codeTom/miniproject/cell_illuminator.png

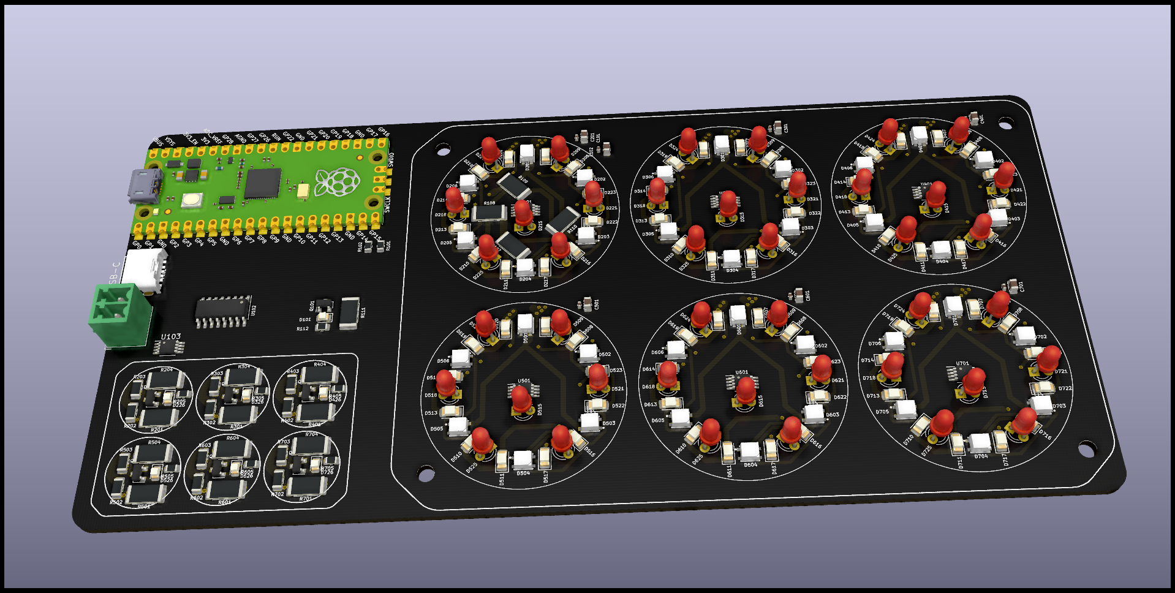
cell_illuminator.png
