codeTom/miniproject/README.md

## Cell photobiomodulation platform

Hardware contains the design files for the PCB (kicad) and for 3D printed components (OpenSCAD).
