codeTom/miniproject/hardware/cover.stl

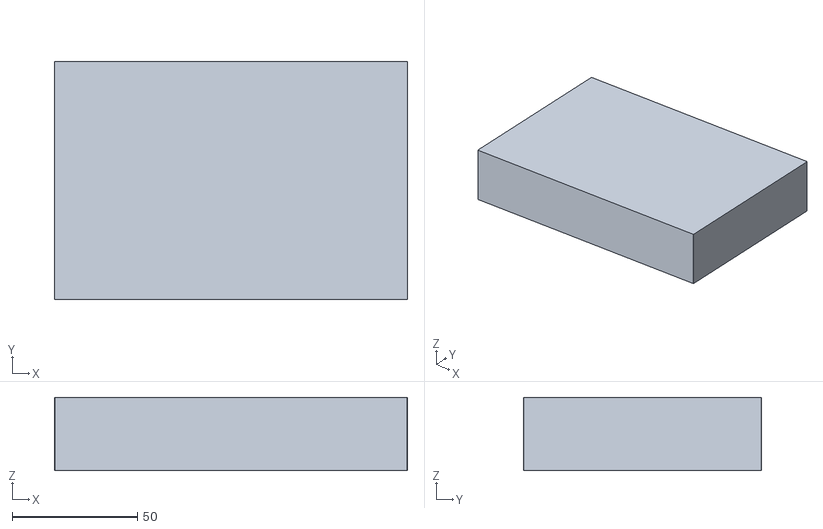
[picture p2: CAD file, 2022-04-08]
hardware/cover.stl
140.8 x 95.0 x 29.2
