codeTom/miniproject/hardware/drawing.dxf

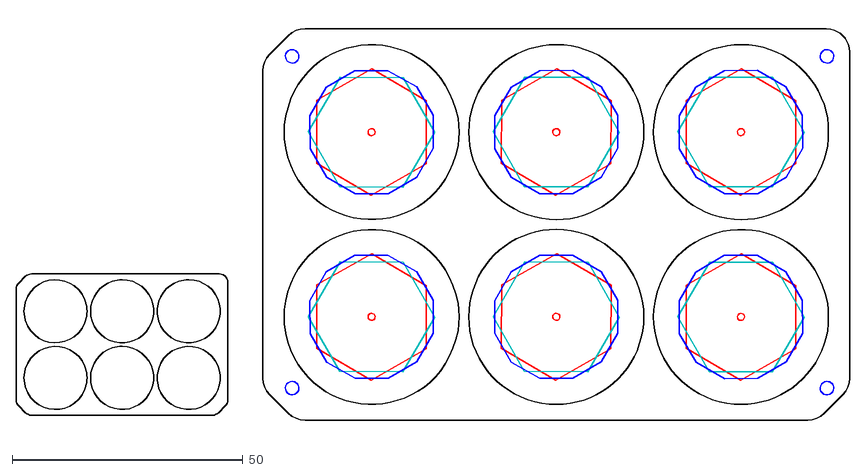
[picture p3: CAD file, 2022-04-08]
hardware/drawing.dxf
180.8 x 90.3
