codeTom/miniproject/hardware/sma_holder_v2.stl

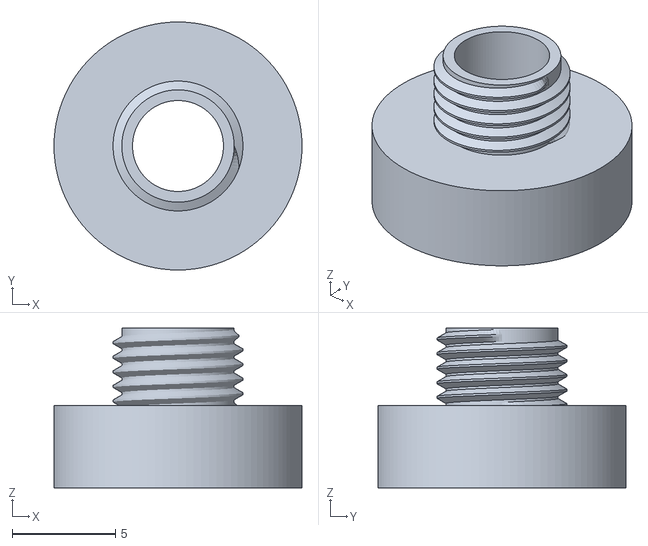
[picture p4: CAD file, 2022-04-08]
hardware/sma_holder_v2.stl
12.0 x 12.0 x 7.74
