codeTom/miniproject/hardware/well_holder_v3.stl

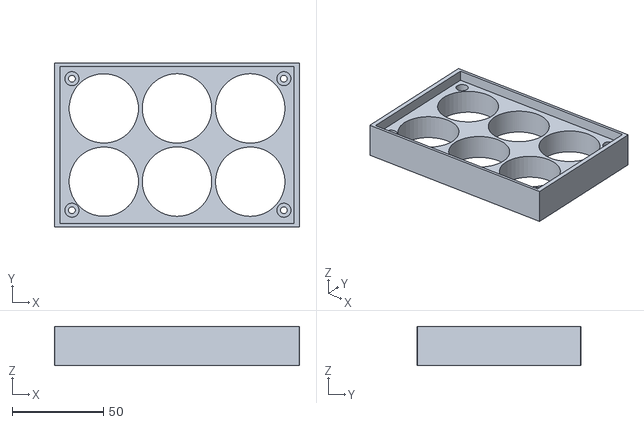
[picture p5: CAD file, 2022-04-08]
hardware/well_holder_v3.stl
134.1 x 89.6 x 21.5
