codeTom/miniproject/hardware/cover_v2.stl

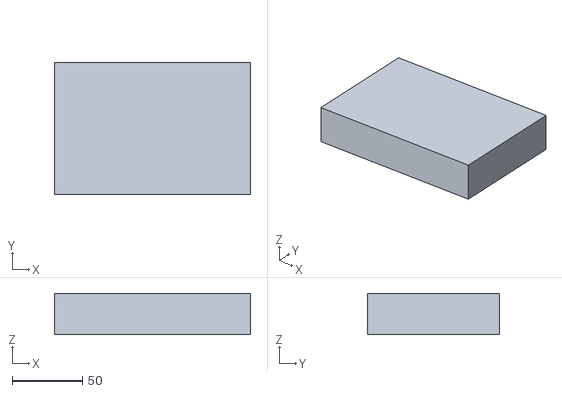
[picture p6: CAD file, 2022-04-08]
hardware/cover_v2.stl
139.4 x 94.1 x 29.2
