codeTom/miniproject/hardware/outline.dxf

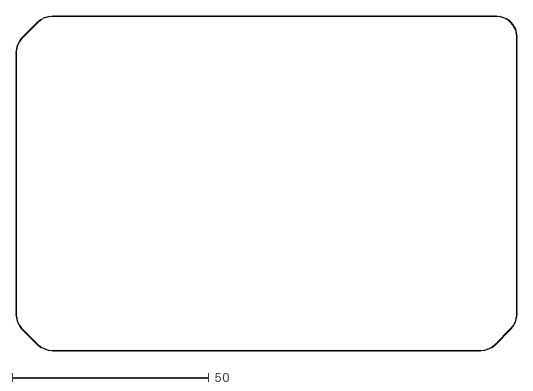
[picture p7: CAD file, 2022-04-08]
hardware/outline.dxf
127.3 x 84.9
