codeTom/miniproject/hardware/wells.dxf

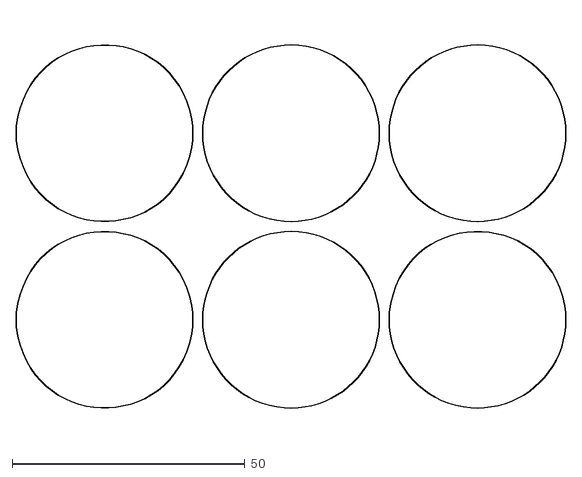
[picture p8: CAD file, 2022-04-08]
hardware/wells.dxf
118.1 x 90.3
