codeTom/miniproject/hardware/drawing_silk.dxf

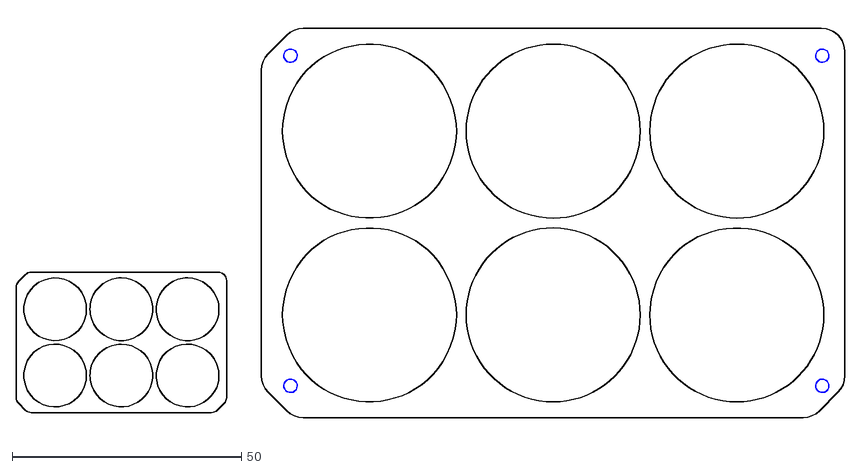
[picture p9: CAD file, 2022-04-08]
hardware/drawing_silk.dxf
180.8 x 90.3
