codeTom/miniproject/hardware/screws.dxf

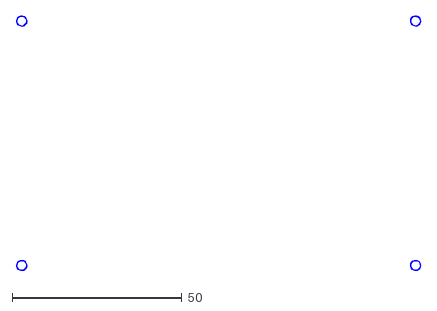
[picture p10: CAD file, 2022-04-08]
hardware/screws.dxf
119.0 x 75.0
