codeTom/miniproject/hardware/cell_illuminator.kicad_pcb

## KiCad design hardware/cell_illuminator.kicad_pcb (2022-04-08)

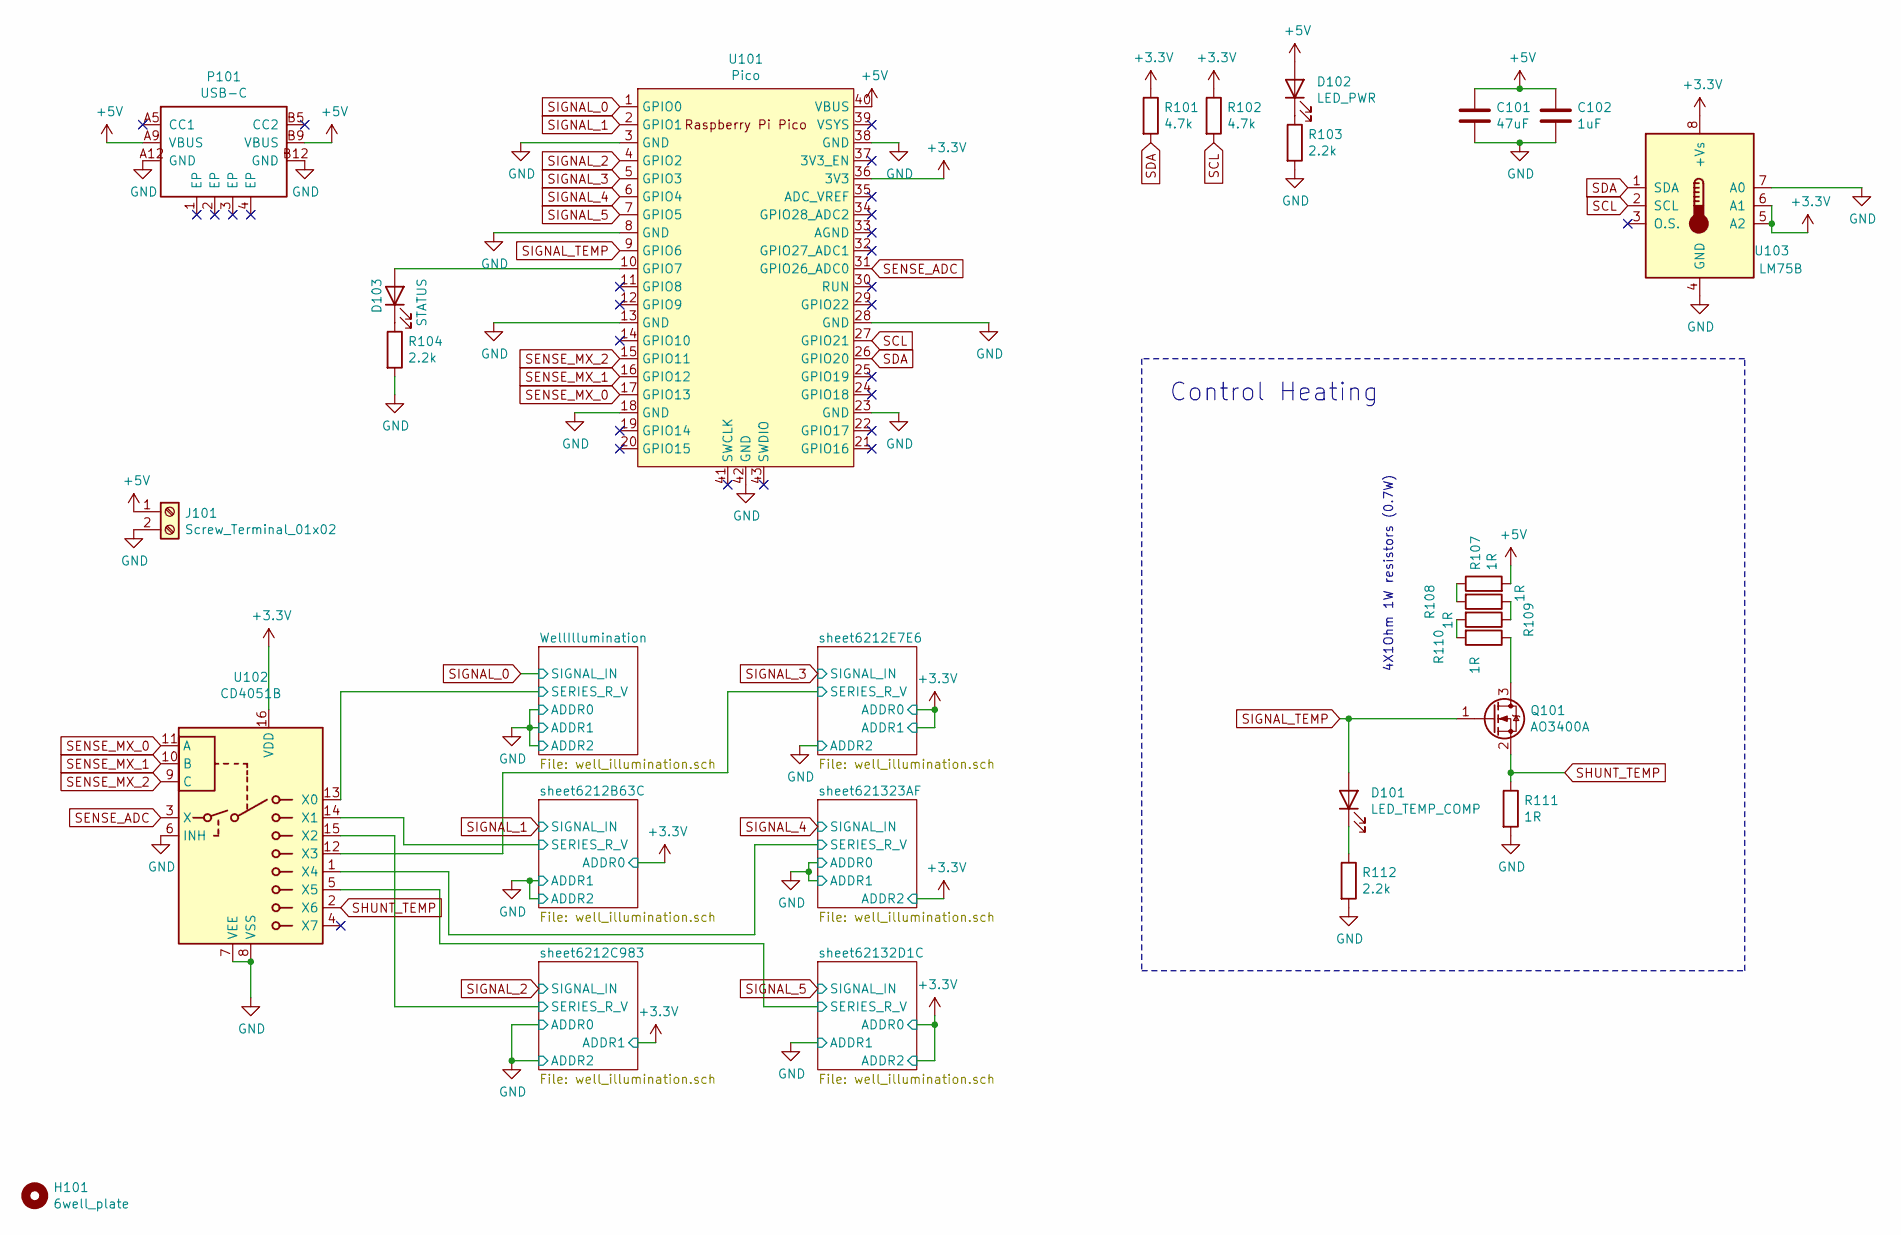
[picture p11: schematic cell_illuminator.sch]

Parts:
C101: 47uF; C_0805_2012Metric; JLCPCB C16780
C102: 1uF; C_0402_1005Metric; JLCPCB C52923
D101: LED_TEMP_COMP; LED_0805_2012Metric; JLCPCB C2293
D102: LED_PWR; LED_0805_2012Metric; JLCPCB C2293
D103: STATUS; LED_0805_2012Metric; JLCPCB C2293
H101: 6well_plate
J101: Screw_Terminal_01x02; PhoenixContact_MCV_1,5_2-G-3.5_1x02_P3.50mm_Vertical
P101: USB-C; TYPE-C-SMD_TYPE-C-31-M-16; JLCPCB C709355
Q101: AO3400A; SOT-23; JLCPCB C20917
R101, R102: 4.7k; R_0805_2012Metric; JLCPCB C17673
R103, R104, R112: 2.2k; R_0805_2012Metric; JLCPCB C17520
R107, R108, R109, R110, R111: 1R; R_2512_6332Metric; JLCPCB C11254
U101: Pico; RPi_Pico_SMD_TH
U102: CD4051B; SOIC-16_3.9x9.9mm_P1.27mm; JLCPCB C21379
U103: LM75B; MSOP-8_3x3mm_P0.65mm; JLCPCB C2837470

Connections:
+3V3: R101.1, R102.1, U101.36 (3V3), U102.16 (VDD), U103.5 (A2), U103.6 (A1), U103.8 (+Vs); also elsewhere on the board
+5V: C101.1, C102.1, D102.2 (A), J101.1, P101.A9 (VBUS), P101.B9 (VBUS), R107.2, U101.40 (VBUS); also elsewhere on the board
/WellIllumination/SERIES_R_V: U102.13 (X0); also elsewhere on the board
/sheet6212B63C/SERIES_R_V: U102.14 (X1); also elsewhere on the board
/sheet6212C983/SERIES_R_V: U102.15 (X2); also elsewhere on the board
/sheet6212E7E6/SERIES_R_V: U102.12 (X3); also elsewhere on the board
/sheet62132D1C/SERIES_R_V: U102.5 (X5); also elsewhere on the board
/sheet621323AF/SERIES_R_V: U102.1 (X4); also elsewhere on the board
GND: C101.2, C102.2, J101.2, P101.A12 (GND), P101.B12 (GND), R103.2, R104.2, R111.2, R112.2, U101.3 (GND), U101.8 (GND), U101.13 (GND), U101.18 (GND), U101.23 (GND), U101.28 (GND), U101.38 (GND), U101.42 (GND), U102.6 (INH), U102.7 (VEE), U102.8 (VSS), U103.4 (GND), U103.7 (A0); also elsewhere on the board
unnamed: D101.1 (K), R112.1
unnamed: D102.1 (K), R103.1
unnamed: D103.1 (K), R104.1
unnamed: D103.2 (A), U101.10 (GPIO7)
unnamed: Q101.3 (D), R110.1
unnamed: R107.1, R108.2
unnamed: R108.1, R109.1
unnamed: R109.2, R110.2
SCL: R102.2, U101.27 (GPIO21), U103.2 (SCL); also elsewhere on the board
SDA: R101.2, U101.26 (GPIO20), U103.1 (SDA); also elsewhere on the board
SENSE_ADC: U101.31 (GPIO26_ADC0), U102.3 (X)
SENSE_MX_0: U101.17 (GPIO13), U102.11 (A)
SENSE_MX_1: U101.16 (GPIO12), U102.10 (B)
SENSE_MX_2: U101.15 (GPIO11), U102.9 (C)
SHUNT_TEMP: Q101.2 (S), R111.1, U102.2 (X6)
SIGNAL_0: U101.1 (GPIO0); also elsewhere on the board
SIGNAL_1: U101.2 (GPIO1); also elsewhere on the board
SIGNAL_2: U101.4 (GPIO2); also elsewhere on the board
SIGNAL_3: U101.5 (GPIO3); also elsewhere on the board
SIGNAL_4: U101.6 (GPIO4); also elsewhere on the board
SIGNAL_5: U101.7 (GPIO5); also elsewhere on the board
SIGNAL_TEMP: D101.2 (A), Q101.1 (G), U101.9 (GPIO6)

Notes on the sheet:
4X1Ohm 1W resistors (0.7W)
Control Heating

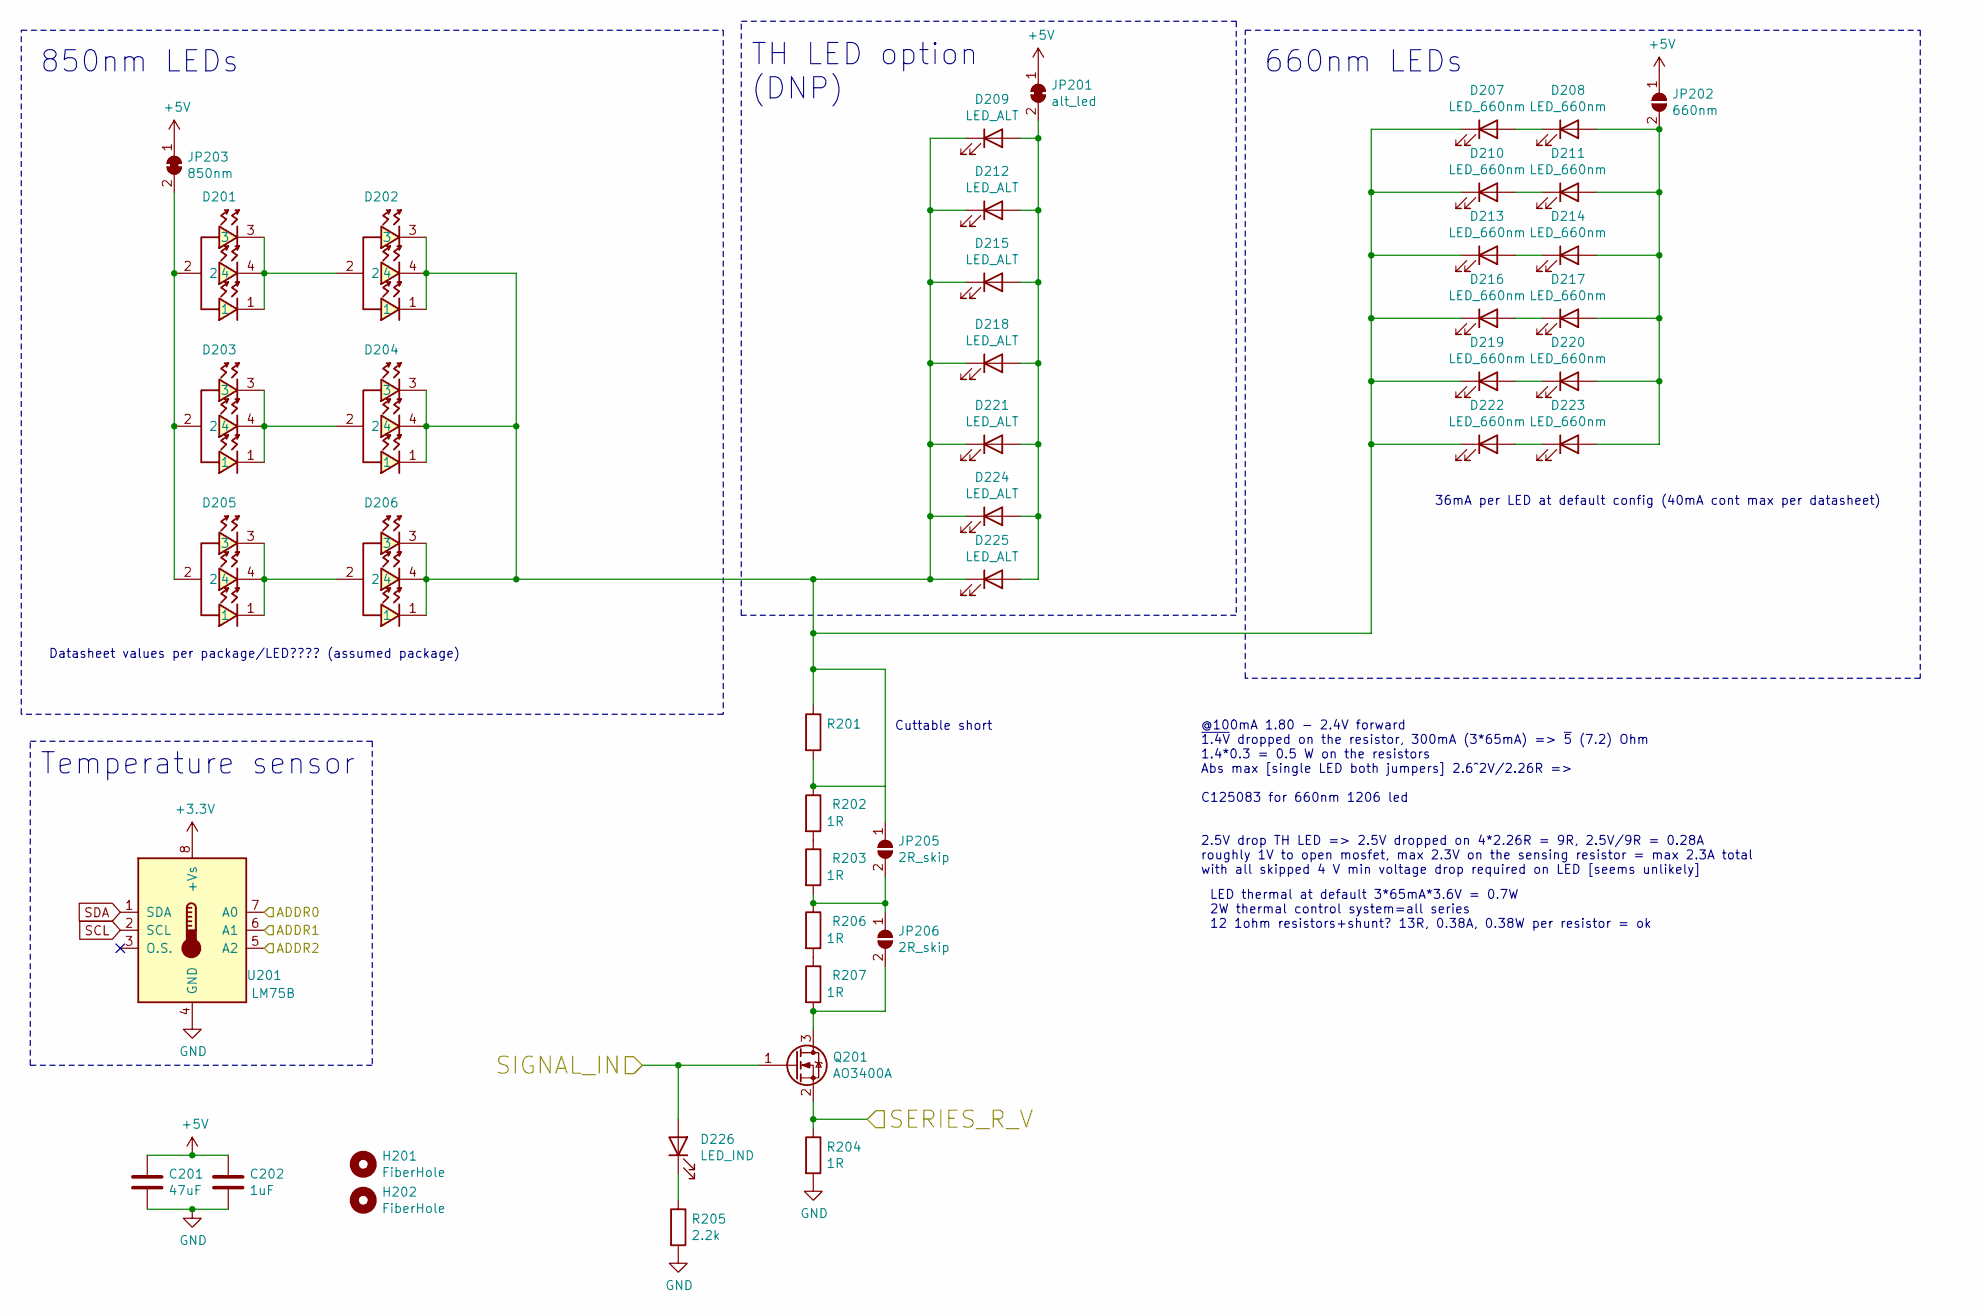
[picture p12: schematic well_illumination.sch]

Parts:
C201: 47uF; C_0805_2012Metric; JLCPCB C16780
C202: 1uF; C_0402_1005Metric; JLCPCB C52923
D201, D202, D203, D204, D205, D206: IR; LED-SMD_4P-L3.2-W2.8-P1.70-TL; JLCPCB C264604
D207, D208, D210, D211, D213, D214, D216, D217, D219, D220, D222, D223: LED_660nm; LED_1206_3216Metric; JLCPCB C125083
D209, D212, D215, D218, D221, D224, D225: LED_ALT; LED_D3.0mm
D226: LED_IND; LED_0805_2012Metric; JLCPCB C2293
H201, H202: FiberHole; MountingHole_3.2mm_M3_small
JP201: alt_led; SolderJumper-2_P1.3mm_Bridged_RoundedPad1.0x1.5mm
JP202: 660nm; SolderJumper-2_P1.3mm_Open_TrianglePad1.0x1.5mm
JP203: 850nm; SolderJumper-2_P1.3mm_Bridged_RoundedPad1.0x1.5mm
JP205, JP206: 2R_skip; SolderJumper-2_P1.3mm_Open_TrianglePad1.0x1.5mm
Q201: AO3400A; SOT-23; JLCPCB C20917
R201: THT; R_Axial_DIN0204_L3.6mm_D1.6mm_P1.90mm_Vertical
R202, R203, R204, R206, R207: 1R; R_2512_6332Metric; JLCPCB C11254
R205: 2.2k; R_0805_2012Metric; JLCPCB C17520
U201: LM75B; MSOP-8_3x3mm_P0.65mm; JLCPCB C2837470

Connections:
+3V3: U201.8 (+Vs); also elsewhere on the board
+5V: C201.1, C202.1, JP201.1 (A), JP202.1 (A), JP203.1 (A); also elsewhere on the board
/WellIllumination/SERIES_R_V: Q201.2 (S), R204.1; also elsewhere on the board
GND: C201.2, C202.2, R204.2, R205.2, U201.4 (GND), U201.5 (A2), U201.6 (A1), U201.7 (A0); also elsewhere on the board
unnamed: D201.1, D201.3, D201.4, D202.2
unnamed: D201.2, D203.2, D205.2, JP203.2 (B)
unnamed: D202.1, D202.3, D202.4, D204.1, D204.3, D204.4, D206.1, D206.3, D206.4, D207.1 (K), D209.1 (K), D210.1 (K), D212.1 (K), D213.1 (K), D215.1 (K), D216.1 (K), D218.1 (K), D219.1 (K), D221.1 (K), D222.1 (K), D224.1 (K), D225.1 (K), JP205.1 (A), R201.1, R201.2, R202.1
unnamed: D203.1, D203.3, D203.4, D204.2
unnamed: D205.1, D205.3, D205.4, D206.2
unnamed: D207.2 (A), D208.1 (K)
unnamed: D208.2 (A), D211.2 (A), D214.2 (A), D217.2 (A), D220.2 (A), D223.2 (A), JP202.2 (B)
unnamed: D209.2 (A), D212.2 (A), D215.2 (A), D218.2 (A), D221.2 (A), D224.2 (A), D225.2 (A), JP201.2 (B)
unnamed: D210.2 (A), D211.1 (K)
unnamed: D213.2 (A), D214.1 (K)
unnamed: D216.2 (A), D217.1 (K)
unnamed: D219.2 (A), D220.1 (K)
unnamed: D222.2 (A), D223.1 (K)
unnamed: D226.1 (K), R205.1
unnamed: JP205.2 (B), JP206.1 (A), R203.2, R206.1
unnamed: JP206.2 (B), Q201.3 (D), R207.2
unnamed: R202.2, R203.1
unnamed: R206.2, R207.1
SCL: U201.2 (SCL); also elsewhere on the board
SDA: U201.1 (SDA); also elsewhere on the board
SIGNAL_0: D226.2 (A), Q201.1 (G); also elsewhere on the board

Parts of its further copies:
C301, C401, C501, C601, C701: 47uF; C_0805_2012Metric; JLCPCB C16780
C302, C402, C502, C602, C702: 1uF; C_0402_1005Metric; JLCPCB C52923
D301, D302, D303, D304, D305, D306, D401, D402, D403, D404, D405, D406, D501, D502, D503, D504, D505, D506, D601, D602, D603, D604, D605, D606, D701, D702, D703, D704, D705, D706: IR; LED-SMD_4P-L3.2-W2.8-P1.70-TL; JLCPCB C264604
D307, D308, D310, D311, D313, D314, D316, D317, D319, D320, D322, D323, D407, D408, D410, D411, D413, D414, D416, D417, D419, D420, D422, D423, D507, D508, D510, D511, D513, D514, D516, D517, D519, D520, D522, D523, D607, D608, D610, D611, D613, D614, D616, D617, D619, D620, D622, D623, D707, D708, D710, D711, D713, D714, D716, D717, D719, D720, D722, D723: LED_660nm; LED_1206_3216Metric; JLCPCB C125083
D309, D312, D315, D318, D321, D324, D325, D409, D412, D415, D418, D421, D424, D425, D509, D512, D515, D518, D521, D524, D525, D609, D612, D615, D618, D621, D624, D625, D709, D712, D715, D718, D721, D724, D725: LED_ALT; LED_D3.0mm
D326, D426, D526, D626, D726: LED_IND; LED_0805_2012Metric; JLCPCB C2293
H301, H302, H401, H402, H501, H502, H601, H602, H701, H702: FiberHole; MountingHole_3.2mm_M3_small
JP301, JP401, JP501, JP601, JP701: alt_led; SolderJumper-2_P1.3mm_Bridged_RoundedPad1.0x1.5mm
JP302, JP402, JP502, JP602, JP702: 660nm; SolderJumper-2_P1.3mm_Open_TrianglePad1.0x1.5mm
JP303, JP403, JP503, JP603, JP703: 850nm; SolderJumper-2_P1.3mm_Bridged_RoundedPad1.0x1.5mm
JP305, JP306, JP405, JP406, JP505, JP506, JP605, JP606, JP705, JP706: 2R_skip; SolderJumper-2_P1.3mm_Open_TrianglePad1.0x1.5mm
Q301, Q401, Q501, Q601, Q701: AO3400A; SOT-23; JLCPCB C20917
R302, R303, R304, R306, R307, R402, R403, R404, R406, R407, R502, R503, R504, R506, R507, R602, R603, R604, R606, R607, R702, R703, R704, R706, R707: 1R; R_2512_6332Metric; JLCPCB C11254
R305, R405, R505, R605, R705: 2.2k; R_0805_2012Metric; JLCPCB C17520
U301, U401, U501, U601, U701: LM75B; MSOP-8_3x3mm_P0.65mm; JLCPCB C2837470

Connections of its further copies:
+3V3: U301.7 (A0), U301.8 (+Vs), U401.6 (A1), U401.8 (+Vs), U501.5 (A2), U501.7 (A0), U501.8 (+Vs), U601.5 (A2), U601.8 (+Vs), U701.6 (A1), U701.7 (A0), U701.8 (+Vs); also elsewhere on the board
+5V: C301.1, C302.1, C401.1, C402.1, C501.1, C502.1, C601.1, C602.1, C701.1, C702.1, JP301.1 (A), JP302.1 (A), JP303.1 (A), JP401.1 (A), JP402.1 (A), JP403.1 (A), JP501.1 (A), JP502.1 (A), JP503.1 (A), JP601.1 (A), JP602.1 (A), JP603.1 (A), JP701.1 (A), JP702.1 (A), JP703.1 (A); also elsewhere on the board
/sheet6212B63C/SERIES_R_V: Q301.2 (S), R304.1; also elsewhere on the board
/sheet6212C983/SERIES_R_V: Q401.2 (S), R404.1; also elsewhere on the board
/sheet6212E7E6/SERIES_R_V: Q701.2 (S), R704.1; also elsewhere on the board
/sheet62132D1C/SERIES_R_V: Q501.2 (S), R504.1; also elsewhere on the board
/sheet621323AF/SERIES_R_V: Q601.2 (S), R604.1; also elsewhere on the board
GND: C301.2, C302.2, C401.2, C402.2, C501.2, C502.2, C601.2, C602.2, C701.2, C702.2, R304.2, R305.2, R404.2, R405.2, R504.2, R505.2, R604.2, R605.2, R704.2, R705.2, U301.4 (GND), U301.5 (A2), U301.6 (A1), U401.4 (GND), U401.5 (A2), U401.7 (A0), U501.4 (GND), U501.6 (A1), U601.4 (GND), U601.6 (A1), U601.7 (A0), U701.4 (GND), U701.5 (A2); also elsewhere on the board
unnamed: D301.1, D301.3, D301.4, D302.2
unnamed: D301.2, D303.2, D305.2, JP303.2 (B)
unnamed 29: D302.1, D302.3, D302.4, D304.1, D304.3, D304.4, D306.1, D306.3, D306.4, D307.1 (K), D309.1 (K), D310.1 (K), D312.1 (K), D313.1 (K), D315.1 (K), D316.1 (K), D318.1 (K), D319.1 (K), D321.1 (K), D322.1 (K), D324.1 (K), D325.1 (K), JP305.1 (A), R302.1; also elsewhere on the board
unnamed: D303.1, D303.3, D303.4, D304.2
unnamed: D305.1, D305.3, D305.4, D306.2
unnamed: D307.2 (A), D308.1 (K)
unnamed: D308.2 (A), D311.2 (A), D314.2 (A), D317.2 (A), D320.2 (A), D323.2 (A), JP302.2 (B)
unnamed: D309.2 (A), D312.2 (A), D315.2 (A), D318.2 (A), D321.2 (A), D324.2 (A), D325.2 (A), JP301.2 (B)
unnamed: D310.2 (A), D311.1 (K)
unnamed: D313.2 (A), D314.1 (K)
unnamed: D316.2 (A), D317.1 (K)
unnamed: D319.2 (A), D320.1 (K)
unnamed: D322.2 (A), D323.1 (K)
unnamed: D326.1 (K), R305.1
unnamed: D401.1, D401.3, D401.4, D402.2
unnamed: D401.2, D403.2, D405.2, JP403.2 (B)
unnamed 43: D402.1, D402.3, D402.4, D404.1, D404.3, D404.4, D406.1, D406.3, D406.4, D407.1 (K), D409.1 (K), D410.1 (K), D412.1 (K), D413.1 (K), D415.1 (K), D416.1 (K), D418.1 (K), D419.1 (K), D421.1 (K), D422.1 (K), D424.1 (K), D425.1 (K), JP405.1 (A), R402.1; also elsewhere on the board
unnamed: D403.1, D403.3, D403.4, D404.2
unnamed: D405.1, D405.3, D405.4, D406.2
unnamed: D407.2 (A), D408.1 (K)
unnamed: D408.2 (A), D411.2 (A), D414.2 (A), D417.2 (A), D420.2 (A), D423.2 (A), JP402.2 (B)
unnamed: D409.2 (A), D412.2 (A), D415.2 (A), D418.2 (A), D421.2 (A), D424.2 (A), D425.2 (A), JP401.2 (B)
unnamed: D410.2 (A), D411.1 (K)
unnamed: D413.2 (A), D414.1 (K)
unnamed: D416.2 (A), D417.1 (K)
unnamed: D419.2 (A), D420.1 (K)
unnamed: D422.2 (A), D423.1 (K)
unnamed: D426.1 (K), R405.1
unnamed: D501.1, D501.3, D501.4, D502.2
unnamed: D501.2, D503.2, D505.2, JP503.2 (B)
unnamed 57: D502.1, D502.3, D502.4, D504.1, D504.3, D504.4, D506.1, D506.3, D506.4, D507.1 (K), D509.1 (K), D510.1 (K), D512.1 (K), D513.1 (K), D515.1 (K), D516.1 (K), D518.1 (K), D519.1 (K), D521.1 (K), D522.1 (K), D524.1 (K), D525.1 (K), JP505.1 (A), R502.1; also elsewhere on the board
unnamed: D503.1, D503.3, D503.4, D504.2
unnamed: D505.1, D505.3, D505.4, D506.2
unnamed: D507.2 (A), D508.1 (K)
unnamed: D508.2 (A), D511.2 (A), D514.2 (A), D517.2 (A), D520.2 (A), D523.2 (A), JP502.2 (B)
unnamed: D509.2 (A), D512.2 (A), D515.2 (A), D518.2 (A), D521.2 (A), D524.2 (A), D525.2 (A), JP501.2 (B)
unnamed: D510.2 (A), D511.1 (K)
unnamed: D513.2 (A), D514.1 (K)
unnamed: D516.2 (A), D517.1 (K)
unnamed: D519.2 (A), D520.1 (K)
unnamed: D522.2 (A), D523.1 (K)
unnamed: D526.1 (K), R505.1
unnamed: D601.1, D601.3, D601.4, D602.2
unnamed: D601.2, D603.2, D605.2, JP603.2 (B)
unnamed 71: D602.1, D602.3, D602.4, D604.1, D604.3, D604.4, D606.1, D606.3, D606.4, D607.1 (K), D609.1 (K), D610.1 (K), D612.1 (K), D613.1 (K), D615.1 (K), D616.1 (K), D618.1 (K), D619.1 (K), D621.1 (K), D622.1 (K), D624.1 (K), D625.1 (K), JP605.1 (A), R602.1; also elsewhere on the board
unnamed: D603.1, D603.3, D603.4, D604.2
unnamed: D605.1, D605.3, D605.4, D606.2
unnamed: D607.2 (A), D608.1 (K)
unnamed: D608.2 (A), D611.2 (A), D614.2 (A), D617.2 (A), D620.2 (A), D623.2 (A), JP602.2 (B)
unnamed: D609.2 (A), D612.2 (A), D615.2 (A), D618.2 (A), D621.2 (A), D624.2 (A), D625.2 (A), JP601.2 (B)
unnamed: D610.2 (A), D611.1 (K)
unnamed: D613.2 (A), D614.1 (K)
unnamed: D616.2 (A), D617.1 (K)
unnamed: D619.2 (A), D620.1 (K)
unnamed: D622.2 (A), D623.1 (K)
unnamed: D626.1 (K), R605.1
unnamed: D701.1, D701.3, D701.4, D702.2
unnamed: D701.2, D703.2, D705.2, JP703.2 (B)
unnamed 85: D702.1, D702.3, D702.4, D704.1, D704.3, D704.4, D706.1, D706.3, D706.4, D707.1 (K), D709.1 (K), D710.1 (K), D712.1 (K), D713.1 (K), D715.1 (K), D716.1 (K), D718.1 (K), D719.1 (K), D721.1 (K), D722.1 (K), D724.1 (K), D725.1 (K), JP705.1 (A), R702.1; also elsewhere on the board
unnamed: D703.1, D703.3, D703.4, D704.2
unnamed: D705.1, D705.3, D705.4, D706.2
unnamed: D707.2 (A), D708.1 (K)
unnamed: D708.2 (A), D711.2 (A), D714.2 (A), D717.2 (A), D720.2 (A), D723.2 (A), JP702.2 (B)
unnamed: D709.2 (A), D712.2 (A), D715.2 (A), D718.2 (A), D721.2 (A), D724.2 (A), D725.2 (A), JP701.2 (B)
unnamed: D710.2 (A), D711.1 (K)
unnamed: D713.2 (A), D714.1 (K)
unnamed: D716.2 (A), D717.1 (K)
unnamed: D719.2 (A), D720.1 (K)
unnamed: D722.2 (A), D723.1 (K)
unnamed: D726.1 (K), R705.1
unnamed: JP305.2 (B), JP306.1 (A), R303.2, R306.1
unnamed: JP306.2 (B), Q301.3 (D), R307.2
unnamed: JP405.2 (B), JP406.1 (A), R403.2, R406.1
unnamed: JP406.2 (B), Q401.3 (D), R407.2
unnamed: JP505.2 (B), JP506.1 (A), R503.2, R506.1
unnamed: JP506.2 (B), Q501.3 (D), R507.2
unnamed: JP605.2 (B), JP606.1 (A), R603.2, R606.1
unnamed: JP606.2 (B), Q601.3 (D), R607.2
unnamed: JP705.2 (B), JP706.1 (A), R703.2, R706.1
unnamed: JP706.2 (B), Q701.3 (D), R707.2
unnamed: R302.2, R303.1
unnamed: R306.2, R307.1
unnamed: R402.2, R403.1
unnamed: R406.2, R407.1
unnamed: R502.2, R503.1
unnamed: R506.2, R507.1
unnamed: R602.2, R603.1
unnamed: R606.2, R607.1
unnamed: R702.2, R703.1
unnamed: R706.2, R707.1
SCL: U301.2 (SCL), U401.2 (SCL), U501.2 (SCL), U601.2 (SCL), U701.2 (SCL); also elsewhere on the board
SDA: U301.1 (SDA), U401.1 (SDA), U501.1 (SDA), U601.1 (SDA), U701.1 (SDA); also elsewhere on the board
SIGNAL_1: D326.2 (A), Q301.1 (G); also elsewhere on the board
SIGNAL_2: D426.2 (A), Q401.1 (G); also elsewhere on the board
SIGNAL_3: D726.2 (A), Q701.1 (G); also elsewhere on the board
SIGNAL_4: D626.2 (A), Q601.1 (G); also elsewhere on the board
SIGNAL_5: D526.2 (A), Q501.1 (G); also elsewhere on the board

Notes on the sheet:
@100mA 1.80 - 2.4V forward ~1.4V dropped on the resistor, 300mA (3*65mA) => ~5 (7.2) Ohm 1.4*0.3 = 0.5 W on the resistors Abs max [single LED both jumpers] 2.6^2V/2.26R => C125083 for 660nm 1206 led
2.5V drop TH LED => 2.5V dropped on 4*2.26R = 9R, 2.5V/9R = 0.28A roughly 1V to open mosfet, max 2.3V on the sensing resistor = max 2.3A total with all skipped 4 V min voltage drop required on LED [seems unlikely]
36mA per LED at default config (40mA cont max per datasheet)
660nm LEDs
850nm LEDs
Datasheet values per package/LED???? (assumed package)
TH LED option (DNP)
Temperature sensor
LED thermal at default 3*65mA*3.6V = 0.7W 2W thermal control system=all series 12 1ohm resistors+shunt? 13R, 0.38A, 0.38W per resistor = ok
Cuttable short

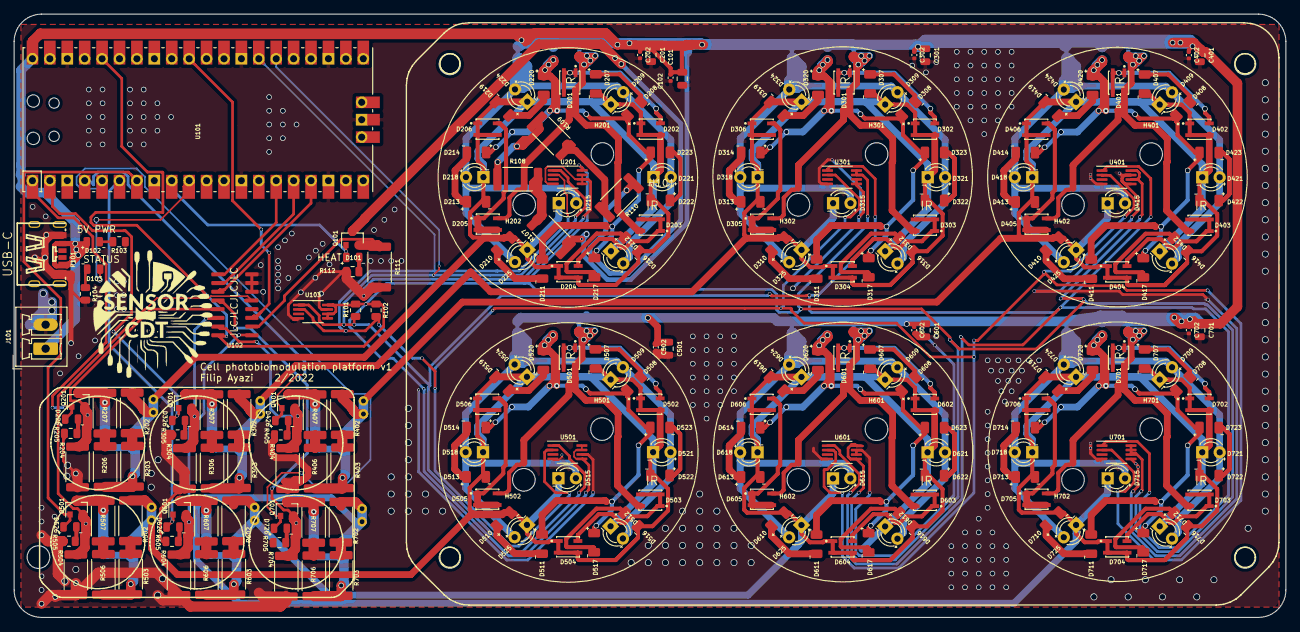
[picture p13: board cell_illuminator.kicad_pcb from above]

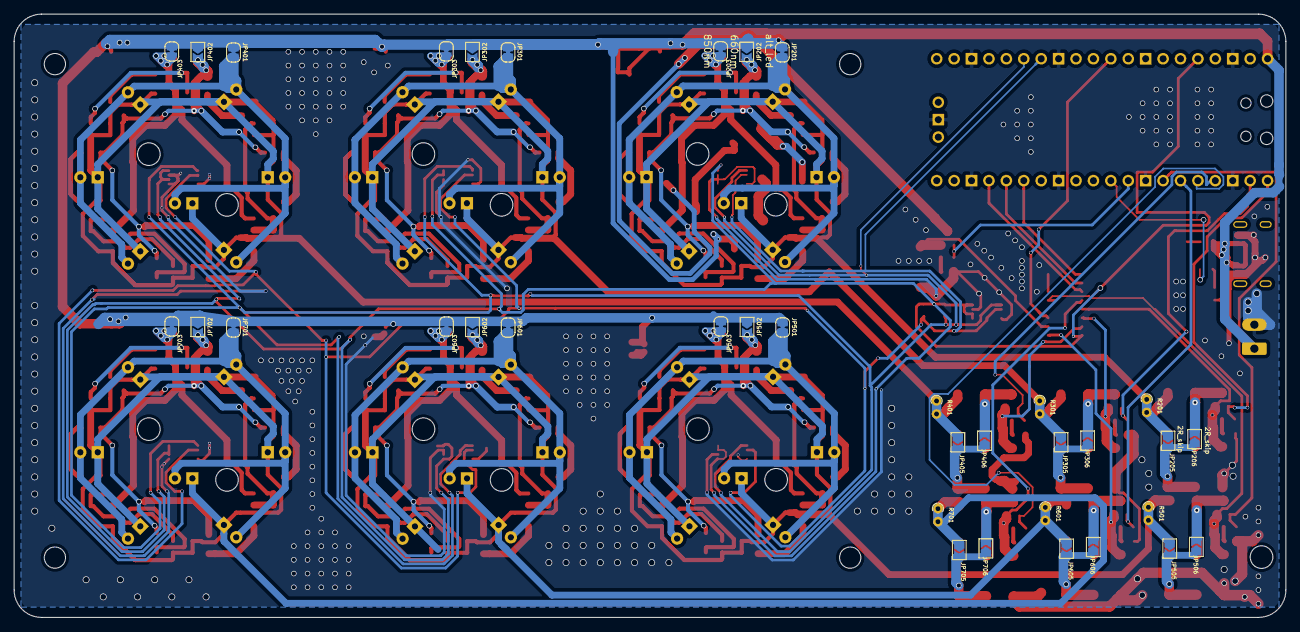
[picture p14: board cell_illuminator.kicad_pcb from below]

Board: 2 copper layers, 185.5 x 88.0 mm, 286 parts (36 on the bottom side), 139 nets.

Other parts of the board:
R301, R401, R501, R601, R701: 1R; R_Axial_DIN0204_L3.6mm_D1.6mm_P1.90mm_Vertical

Their connections:
unnamed 29: R301.1, R301.2; also elsewhere on the board
unnamed 43: R401.1, R401.2; also elsewhere on the board
unnamed 57: R501.1, R501.2; also elsewhere on the board
unnamed 71: R601.1, R601.2; also elsewhere on the board
unnamed 85: R701.1, R701.2; also elsewhere on the board
